dongero/dualdrum/p2/dualdrum.kicad_pcb

## KiCad design p2/dualdrum.kicad_pcb (2019-08-30)

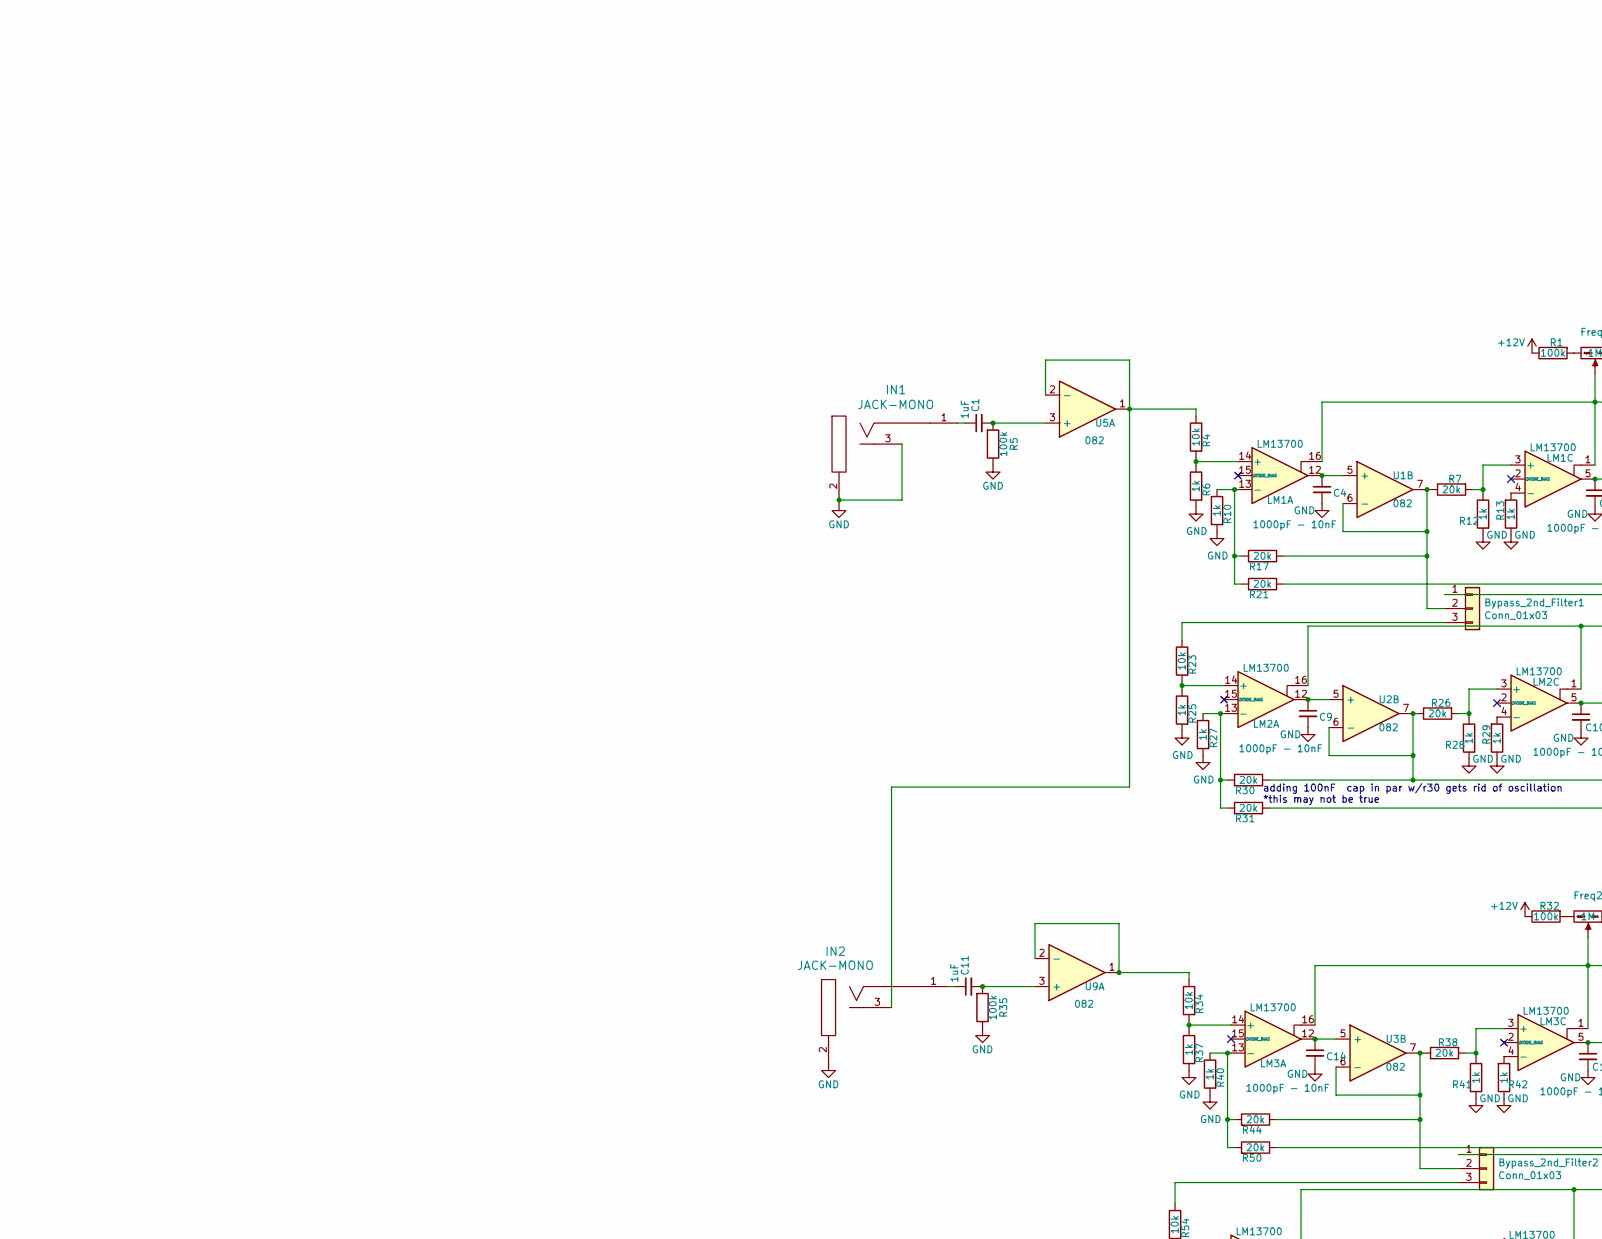
[picture p1: schematic dualdrum.sch, part in row 1, column 1]

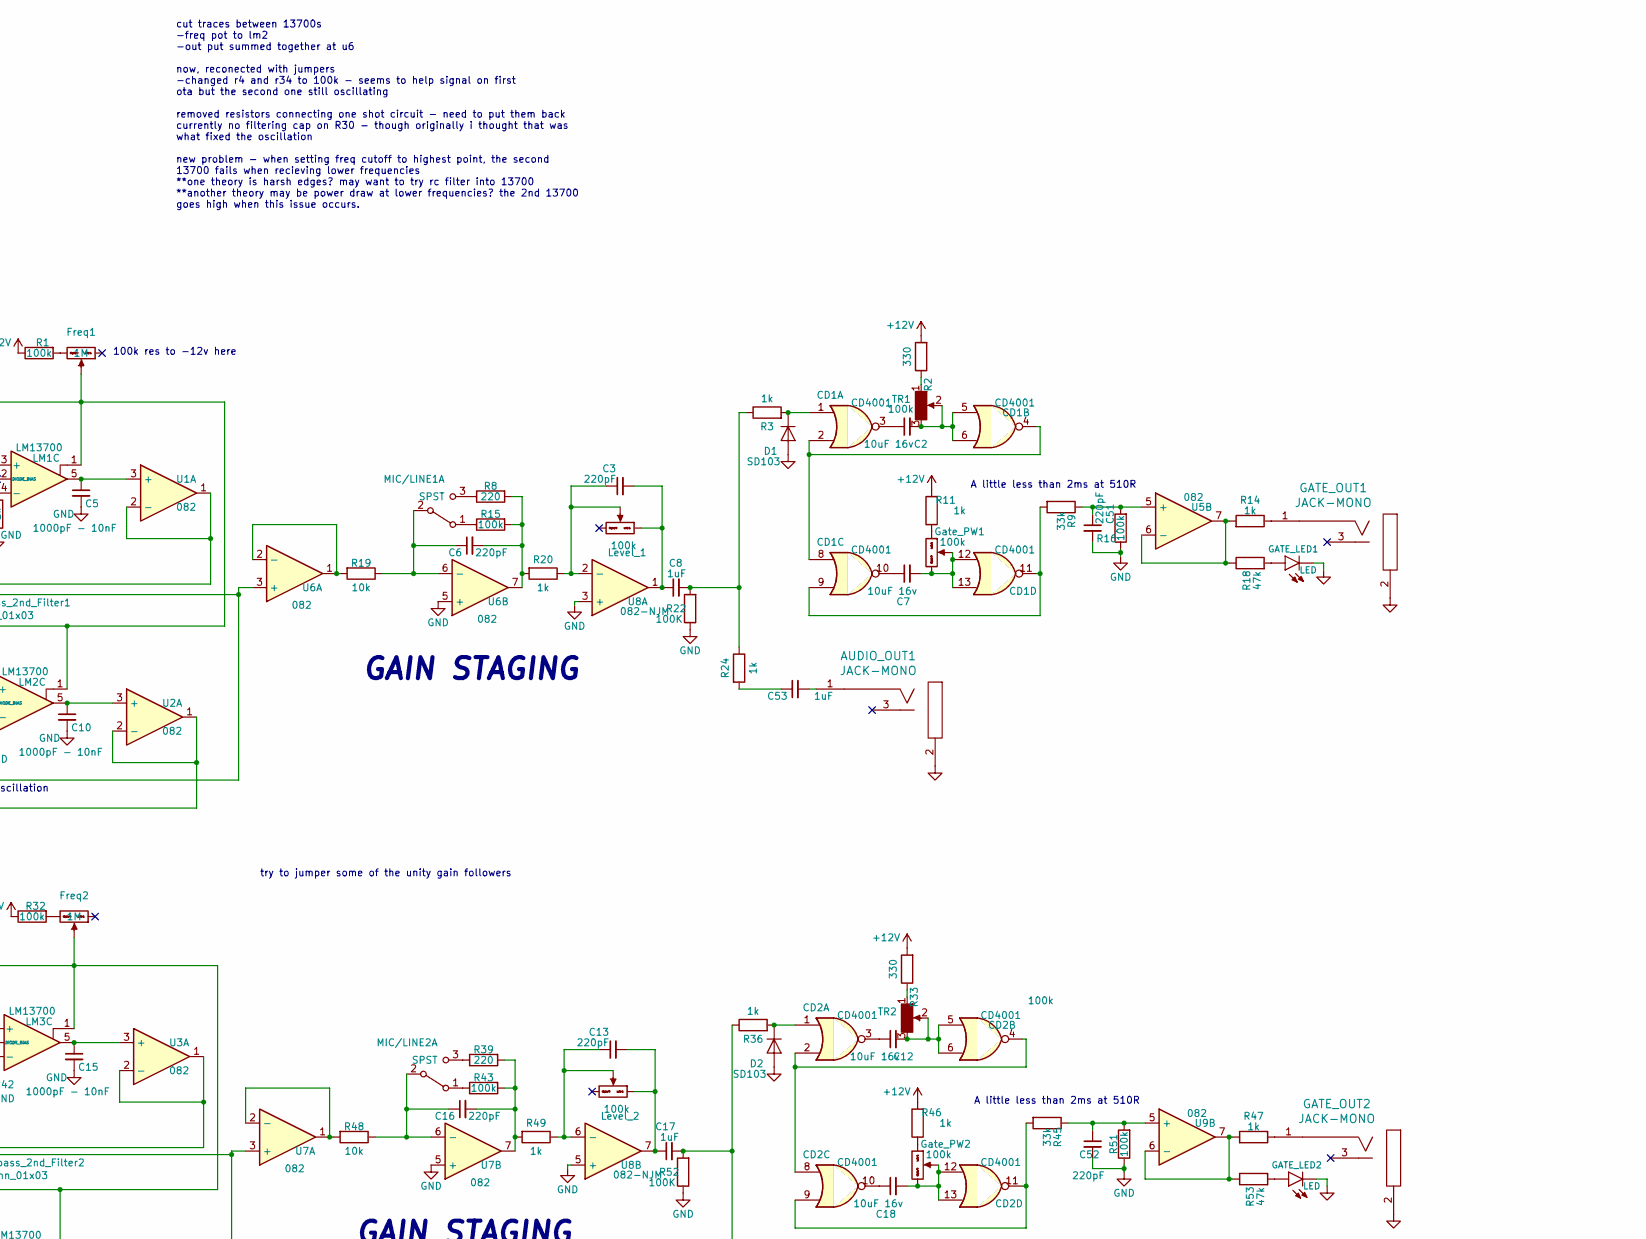
[picture p2: schematic dualdrum.sch, part in row 1, column 2]

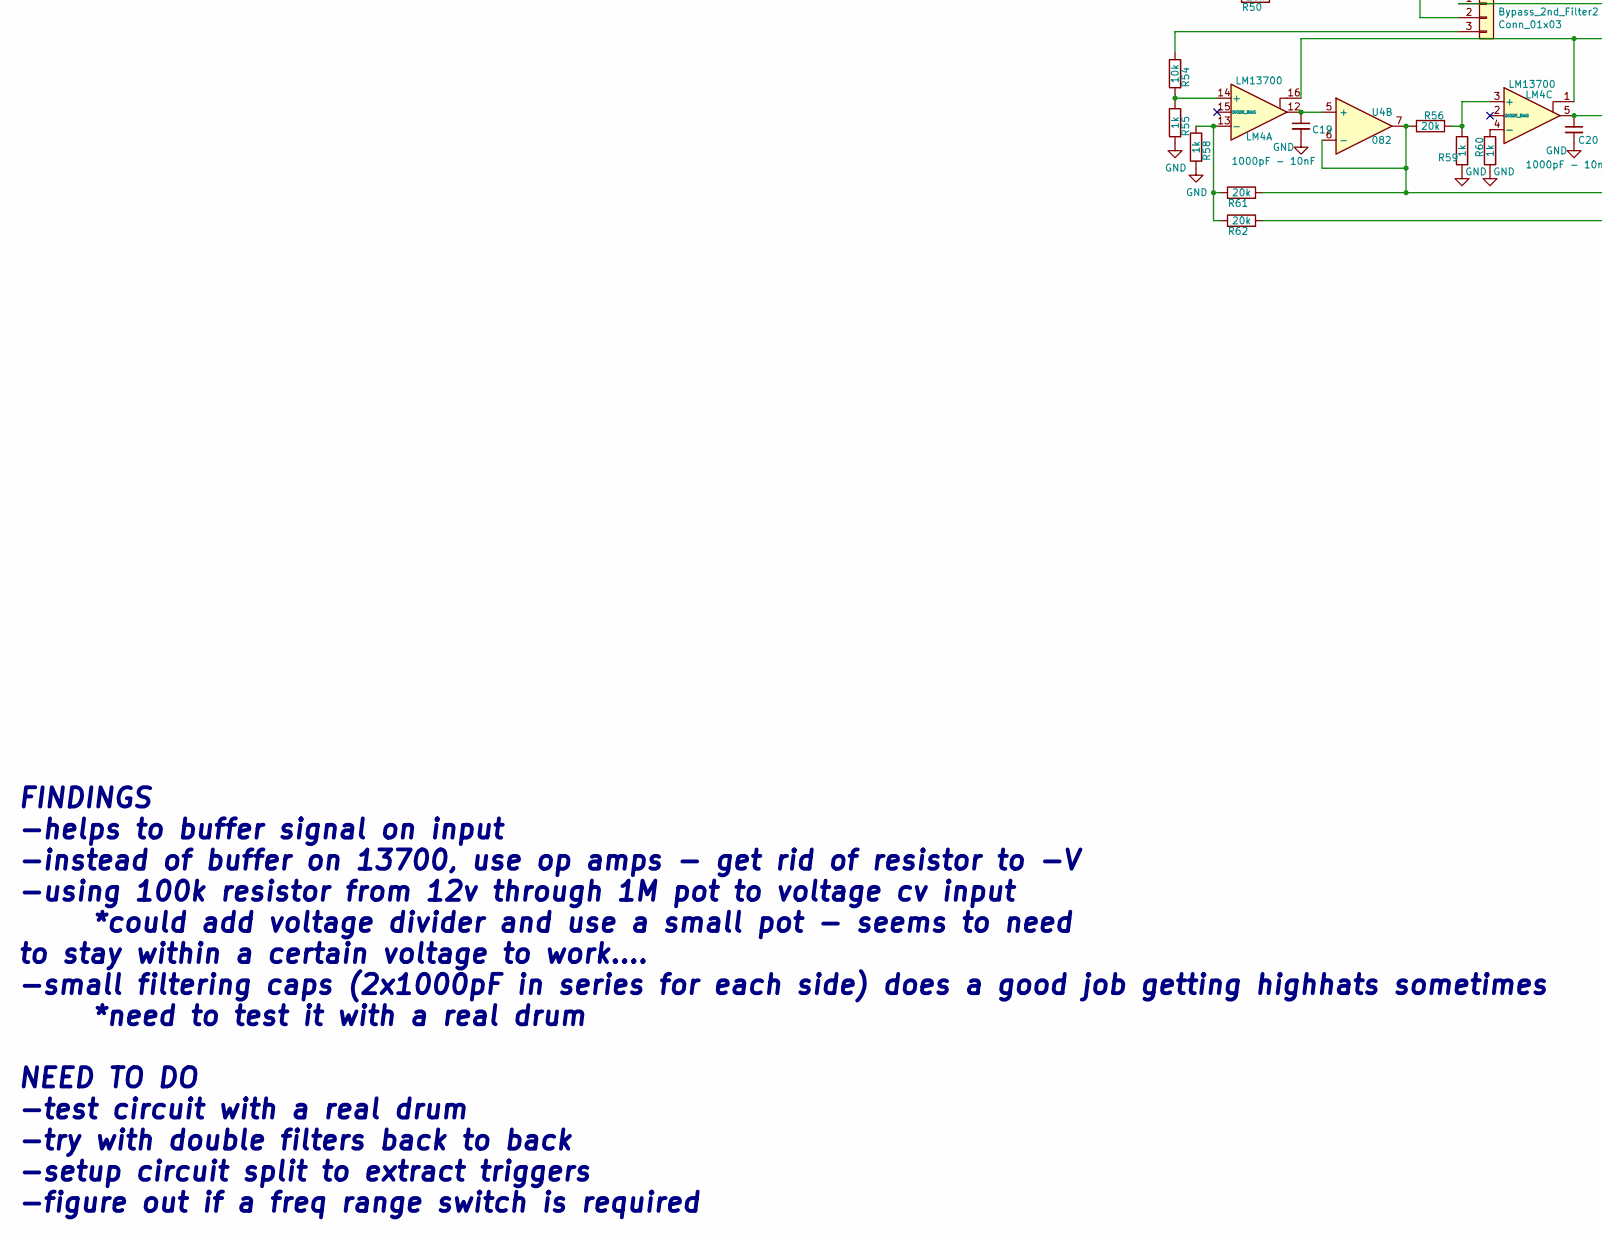
[picture p3: schematic dualdrum.sch, part in row 2, column 1]

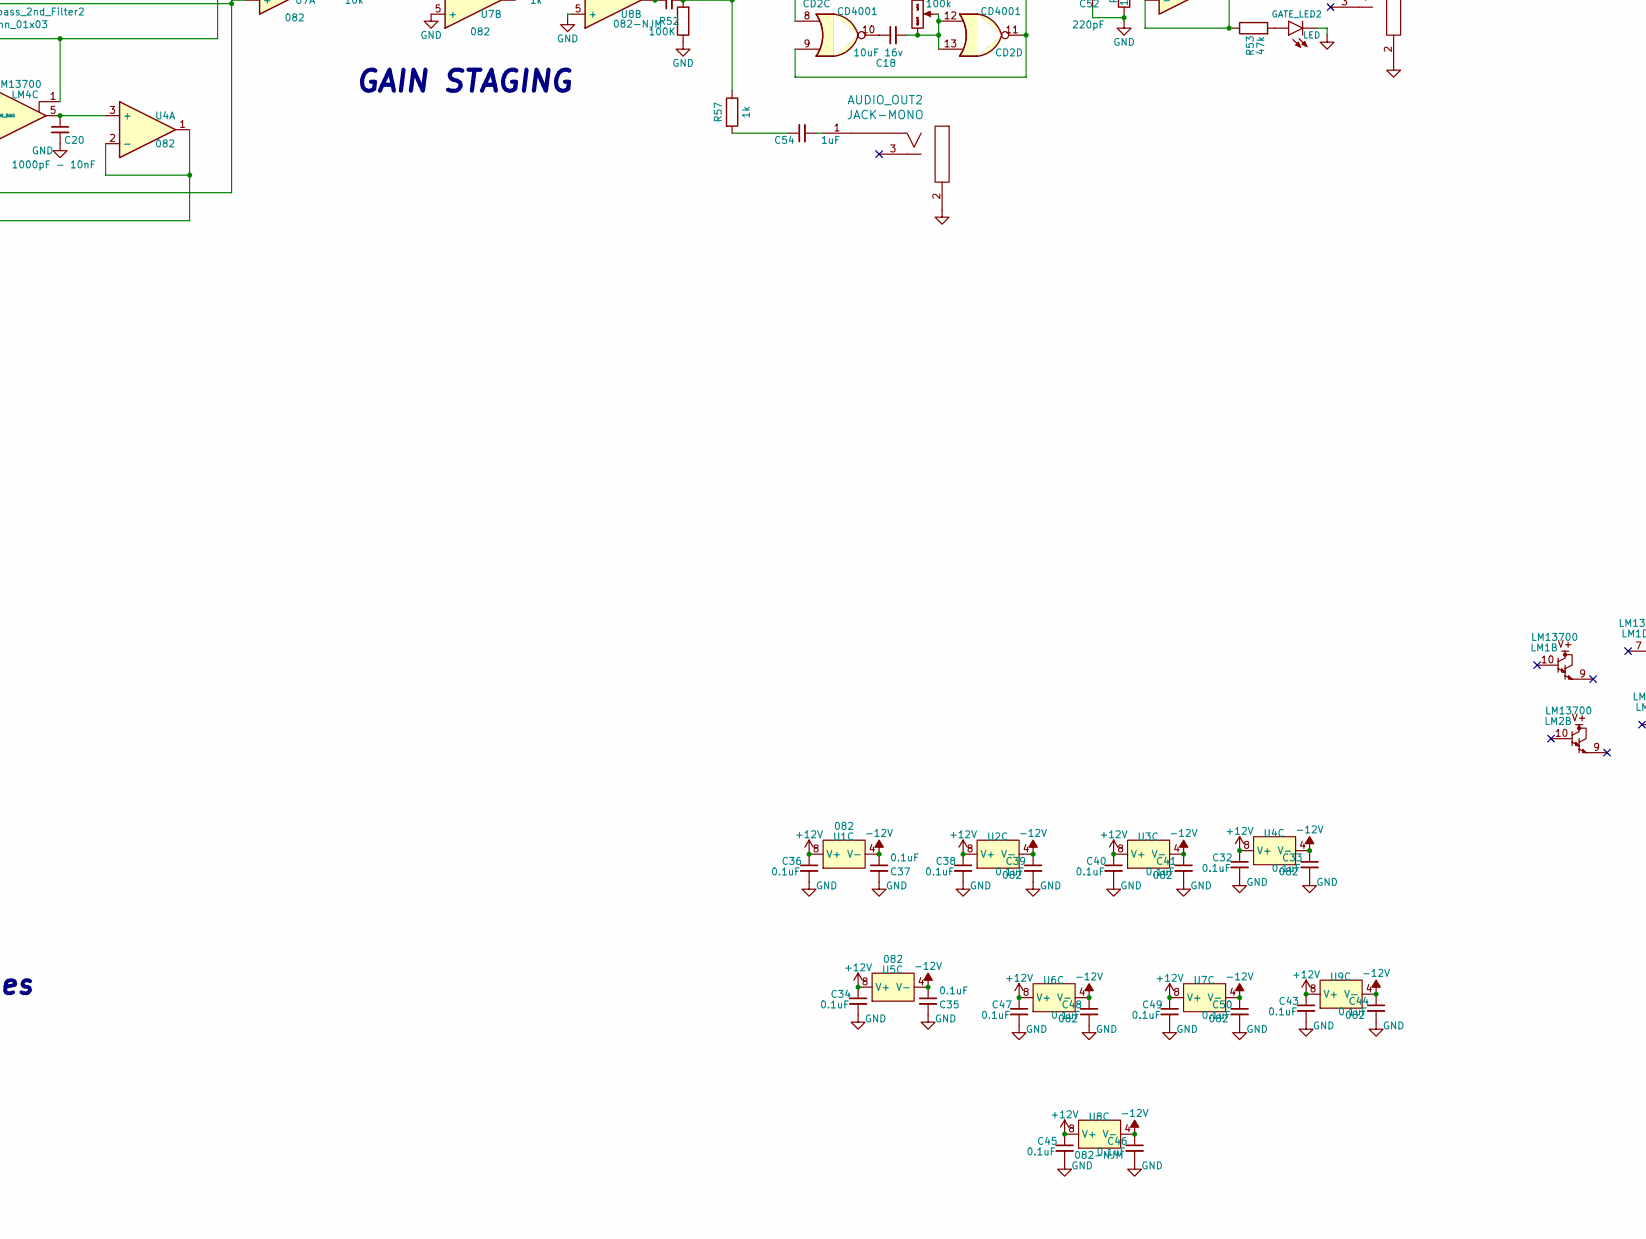
[picture p4: schematic dualdrum.sch, part in row 2, column 2]

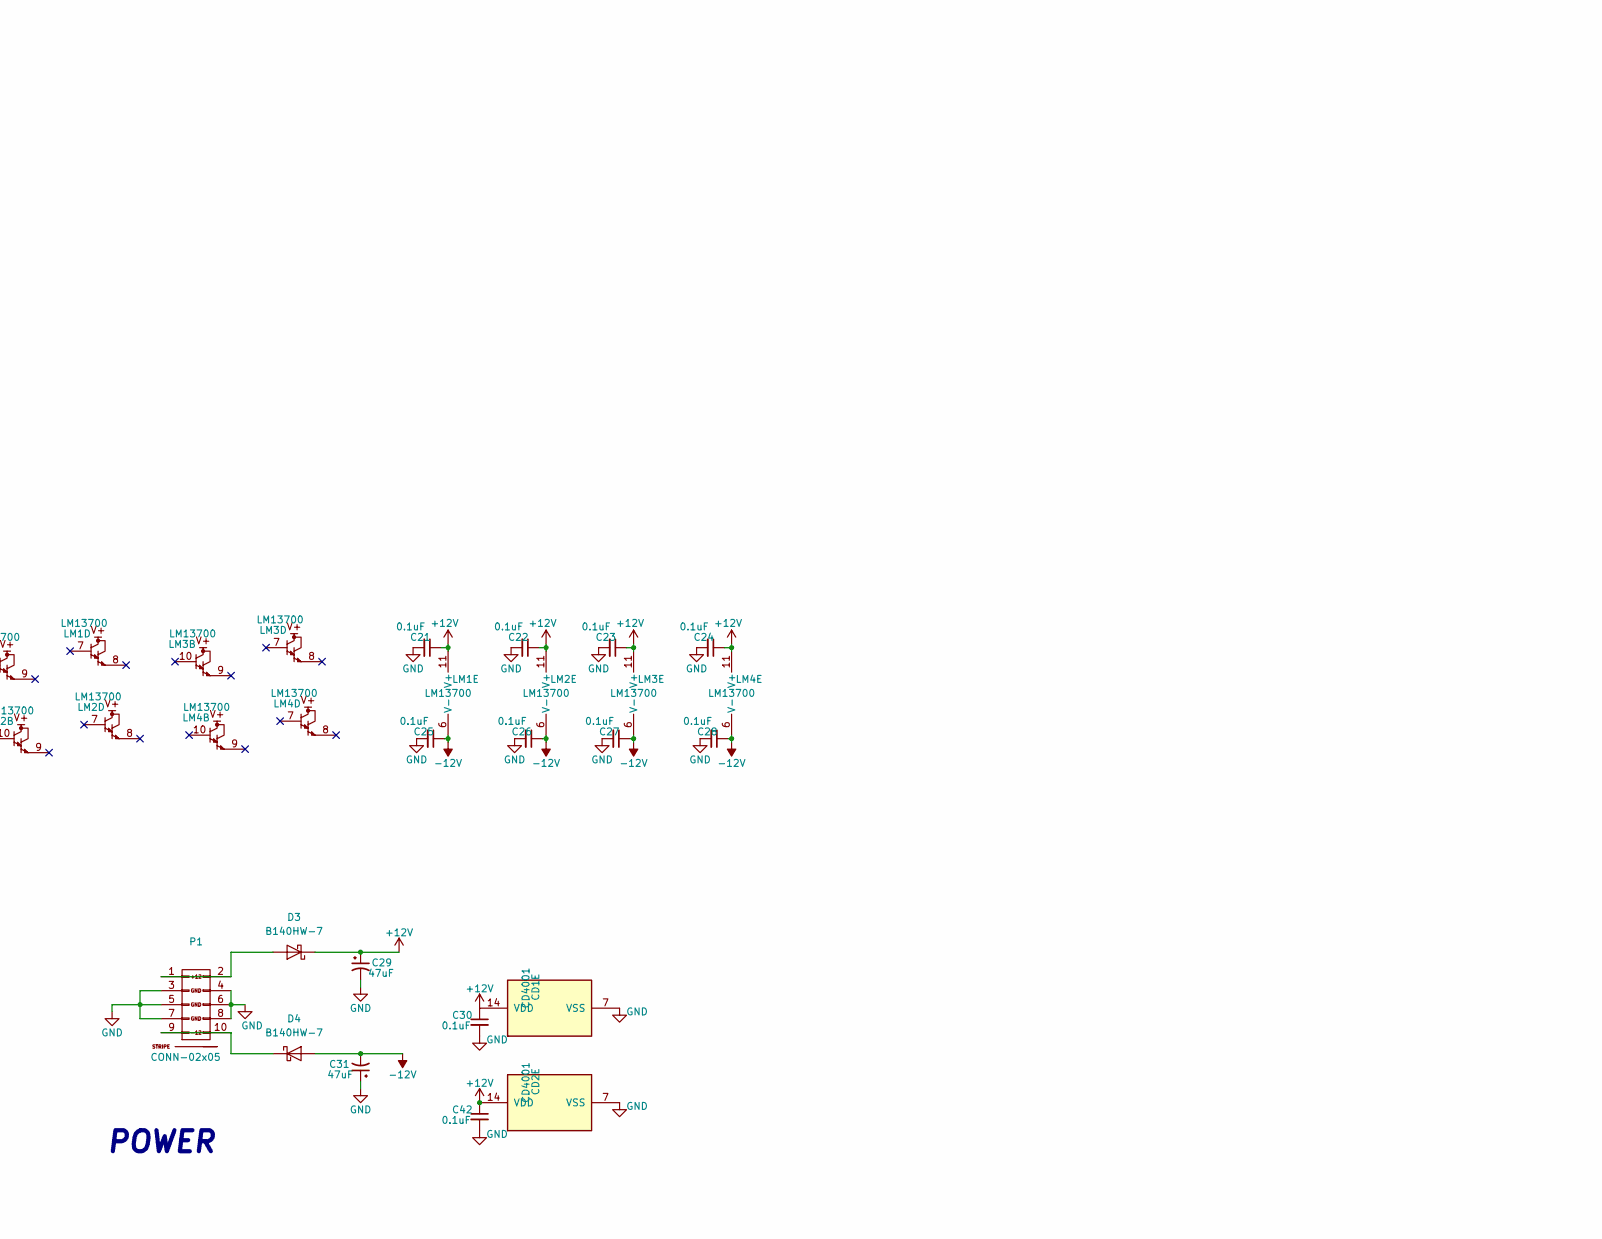
[picture p5: schematic dualdrum.sch, part in row 2, column 3]

Parts:
AUDIO_OUT1, AUDIO_OUT2: JACK-MONO; EighthInch_PJ398SM
Bypass_2nd_Filter1, Bypass_2nd_Filter2: Conn_01x03; Pins_1x03_2.54mm_TH
C1, C11: 1uF; C_0603; Part Number TES
C2, C7, C12, C18: 10uF 16v; C_0805; Part Number TEST
C3, C6, C13, C16, C51, C52: 220pF; C_0603; Part Number TEST
C4, C5, C9, C10, C14, C15, C19, C20: 1000pF - 10nF; C_0603; Part Number TEST
C8, C17, C53, C54: 1uF; C_0603; Part Number TEST
C21, C22, C23, C24, C25, C26, C27, C28, C30, C32, C33, C34, C35, C36, C37, C38, C39, C40, C41, C42, C43, C44, C45, C46, C47, C48, C49, C50: 0.1uF; C_0603; Part Number TEST
C29, C31: 47uF; CP_Elec_5x5.3; Part Number TEST
CD1, CD2: CD4001; SOIC-14_3.9x8.65mm_Pitch1.27mm
D1, D2: SD103; D_SOD-323F
D3, D4: B140HW-7; D_SOD-123
Freq1, Freq2: 1M; Pot_16mm_NoDet_RV16AF-4A
GATE_LED1, GATE_LED2: LED; LED_0603_1608Metric
GATE_OUT1, GATE_OUT2: JACK-MONO; EighthInch_PJ398SM
Gate_PW1, Gate_PW2: 100k; Pot_9mm_Knurl_NoDet
IN1, IN2: JACK-MONO; EighthInch_PJ398SM
LM1, LM2, LM3, LM4: LM13700; SOIC-16_3.9x9.9mm_Pitch1.27mm
Level_1, Level_2: 100k; Pot_16mm_NoDet_RV16AF-4A
MIC/LINE1, MIC/LINE2: SPST; Switch_Toggle_SPDT_SubMini
P1: CONN-02x05; Pins_2x05_2.54mm_TH_Europower
R1, R5, R15, R16, R32, R35, R43, R51: 100k; R_0603; Part Number RC0603FR-07XXXL
R2, R33: 330; R_0603; Part Number RC0603FR-07XXXL
R3, R6, R10, R11, R12, R13, R14, R20, R24, R25, R27, R28, R29, R36, R37, R40, R41, R42, R46, R47, R49, R55, R57, R58, R59, R60: 1k; R_0603; Part Number RC0603FR-07XXXL
R4, R19, R23, R34, R48, R54: 10k; R_0603; Part Number RC0603FR-07XXXL
R7, R17, R21, R26, R30, R31, R38, R44, R50, R56, R61, R62: 20k; R_0603; Part Number RC0603FR-07XXXL
R8, R39: 220; R_0603; Part Number RC0603FR-07XXXL
R9, R45: 33k; R_0603; Part Number RC0603FR-07XXXL
R18, R53: 47k; R_0603; Part Number RC0603FR-07XXXL
R22, R52: 100K; R_0603; Part Number RC0603FR-07XXXL
TR1, TR2: 100k; Pot_Trim_SMT_TC33X
U1, U2, U3, U4, U5, U6, U7, U9: 082; TSSOP-8_4.4x3mm_Pitch0.65mm
U8: 082-NJM; TSSOP-8_4.4x3mm_Pitch0.65mm

Connections:
+12V: C21.1, C22.1, C23.1, C24.1, C29.1, C30.1, C32.1, C34.1, C36.1, C38.1, C40.1, C42.1, C43.1, C45.1, C47.1, C49.1, CD1.14 (VDD), CD2.14 (VDD), D3.1 (K), LM1.11 (V+), LM2.11 (V+), LM3.11 (V+), LM4.11 (V+), R1.1, R2.2, R11.2, R32.1, R33.2, R46.2, U1.8 (V+), U2.8 (V+), U3.8 (V+), U4.8 (V+), U5.8 (V+), U6.8 (V+), U7.8 (V+), U8.8 (V+), U9.8 (V+)
-12VA: C25.1, C26.1, C27.1, C28.1, C31.2, C33.1, C35.1, C37.1, C39.1, C41.1, C44.1, C46.1, C48.1, C50.1, D4.2 (A), LM1.6 (V-), LM2.6 (V-), LM3.6 (V-), LM4.6 (V-), U1.4 (V-), U2.4 (V-), U3.4 (V-), U4.4 (V-), U5.4 (V-), U6.4 (V-), U7.4 (V-), U8.4 (V-), U9.4 (V-)
GND: AUDIO_OUT1.2 (SHEILD), AUDIO_OUT2.2 (SHEILD), C4.2, C5.2, C9.2, C10.2, C14.2, C15.2, C19.2, C20.2, C21.2, C22.2, C23.2, C24.2, C25.2, C26.2, C27.2, C28.2, C29.2, C30.2, C31.1, C32.2, C33.2, C34.2, C35.2, C36.2, C37.2, C38.2, C39.2, C40.2, C41.2, C42.2, C43.2, C44.2, C45.2, C46.2, C47.2, C48.2, C49.2, C50.2, C51.2, C52.2, CD1.7 (VSS), CD2.7 (VSS), D1.2 (A), D2.2 (A), GATE_LED1.2 (C), GATE_LED2.2 (C), GATE_OUT1.2 (SHEILD), GATE_OUT2.2 (SHEILD), IN1.2 (SHEILD), IN1.3 (SW), IN2.2 (SHEILD), P1.3 (GND), P1.4 (GND), P1.5 (GND), P1.6 (GND), P1.7 (GND), P1.8 (GND), R5.1, R6.2, R10.2, R12.2, R13.1, R16.1, R22.1, R25.2, R27.2, R28.2, R29.1, R35.1, R37.2, R40.2, R41.2, R42.1, R51.1, R52.1, R55.2, R58.2, R59.2, R60.1, U6.5 (+), U7.5 (+), U8.3 (+), U8.5 (+)
unnamed: AUDIO_OUT1.1 (SIG), C53.2
unnamed: AUDIO_OUT2.1 (SIG), C54.2
unnamed: Bypass_2nd_Filter1.1, R26.1, R30.1, U2.6 (-), U2.7, U6.3 (+)
unnamed: Bypass_2nd_Filter1.2, R7.1, R17.1, U1.6 (-), U1.7
unnamed: Bypass_2nd_Filter1.3, R23.1
unnamed: Bypass_2nd_Filter2.1, R56.1, R61.1, U4.6 (-), U4.7, U7.3 (+)
unnamed: Bypass_2nd_Filter2.2, R38.1, R44.1, U3.6 (-), U3.7
unnamed: Bypass_2nd_Filter2.3, R54.1
unnamed: C1.1, IN1.1 (SIG)
unnamed: C1.2, R5.2, U5.3 (+)
unnamed: C2.1, CD1.3
unnamed: C2.2, CD1.5, CD1.6, TR1.2 (Center), TR1.3 (Right)
unnamed: C3.1, Level_1.2 (Center), R20.1, U8.2 (-)
unnamed: C3.2, C8.1, Level_1.1 (Left), U8.1
unnamed: C4.1, LM1.12, U1.5 (+)
unnamed: C5.1, LM1.5, U1.3 (+)
unnamed: C6.1, MIC/LINE1.2 (B), R19.1, U6.6 (-)
unnamed: C6.2, R8.2, R15.2, R20.2, U6.7
unnamed: C7.1, CD1.10
unnamed: C7.2, CD1.12, CD1.13, Gate_PW1.2 (Center), Gate_PW1.3 (Right)
unnamed: C8.2, R3.1, R22.2, R24.1
unnamed: C9.1, LM2.12, U2.5 (+)
unnamed: C10.1, LM2.5, U2.3 (+)
unnamed: C11.1, IN2.1 (SIG)
unnamed: C11.2, R35.2, U9.3 (+)
unnamed: C12.1, CD2.3
unnamed: C12.2, CD2.5, CD2.6, TR2.2 (Center), TR2.3 (Right)
unnamed: C13.1, Level_2.2 (Center), R49.1, U8.6 (-)
unnamed: C13.2, C17.1, Level_2.1 (Left), U8.7
unnamed: C14.1, LM3.12, U3.5 (+)
unnamed: C15.1, LM3.5, U3.3 (+)
unnamed: C16.1, MIC/LINE2.2 (B), R48.1, U7.6 (-)
unnamed: C16.2, R39.2, R43.2, R49.2, U7.7
unnamed: C17.2, R36.1, R52.2, R57.1
unnamed: C18.1, CD2.10
unnamed: C18.2, CD2.12, CD2.13, Gate_PW2.2 (Center), Gate_PW2.3 (Right)
unnamed: C19.1, LM4.12, U4.5 (+)
unnamed: C20.1, LM4.5, U4.3 (+)
unnamed: C51.1, R9.1, R16.2, U5.5 (+)
unnamed: C52.1, R45.1, R51.2, U9.5 (+)
unnamed: C53.1, R24.2
unnamed: C54.1, R57.2
unnamed: CD1.1, D1.1 (K), R3.2
unnamed: CD1.2, CD1.4, CD1.8
unnamed: CD1.9, CD1.11, R9.2
unnamed: CD2.1, D2.1 (K), R36.2
unnamed: CD2.2, CD2.4, CD2.8
unnamed: CD2.9, CD2.11, R45.2
unnamed: D3.2 (A), P1.1 (+12V), P1.2 (+12V)
unnamed: D4.1 (K), P1.9 (-12V), P1.10 (-12V)
unnamed: Freq1.2 (Center), LM1.1, LM1.16, LM2.1, LM2.16
unnamed: Freq1.3 (Right), R1.2
unnamed: Freq2.2 (Center), LM3.1, LM3.16, LM4.1, LM4.16
unnamed: Freq2.3 (Right), R32.2
unnamed: GATE_LED1.1 (A), R18.2
unnamed: GATE_LED2.1 (A), R53.2
unnamed: GATE_OUT1.1 (SIG), R14.1
unnamed: GATE_OUT2.1 (SIG), R47.1
unnamed: Gate_PW1.1 (Left), R11.1
unnamed: Gate_PW2.1 (Left), R46.1
unnamed: IN2.3 (SW), R4.1, U5.1, U5.2 (-)
unnamed: LM1.3 (+), R7.2, R12.1
unnamed: LM1.4 (-), R13.2
unnamed: LM1.13 (-), R10.1, R17.2, R21.2
unnamed: LM1.14 (+), R4.2, R6.1
unnamed: LM2.3 (+), R26.2, R28.1
unnamed: LM2.4 (-), R29.2
unnamed: LM2.13 (-), R27.1, R30.2, R31.2
unnamed: LM2.14 (+), R23.2, R25.1
unnamed: LM3.3 (+), R38.2, R41.1
unnamed: LM3.4 (-), R42.2
unnamed: LM3.13 (-), R40.1, R44.2, R50.2
unnamed: LM3.14 (+), R34.2, R37.1
unnamed: LM4.3 (+), R56.2, R59.1
unnamed: LM4.4 (-), R60.2
unnamed: LM4.13 (-), R58.1, R61.2, R62.2
unnamed: LM4.14 (+), R54.2, R55.1
unnamed: MIC/LINE1.1 (A), R15.1
unnamed: MIC/LINE1.3 (C), R8.1
unnamed: MIC/LINE2.1 (A), R43.1
unnamed: MIC/LINE2.3 (C), R39.1
unnamed: R2.1, TR1.1 (Left)
unnamed: R14.2, R18.1, U5.6 (-), U5.7
unnamed: R19.2, U6.1, U6.2 (-)
unnamed: R21.1, U1.1, U1.2 (-)
unnamed: R31.1, U2.1, U2.2 (-)
unnamed: R33.1, TR2.1 (Left)
unnamed: R34.1, U9.1, U9.2 (-)
unnamed: R47.2, R53.1, U9.6 (-), U9.7
unnamed: R48.2, U7.1, U7.2 (-)
unnamed: R50.1, U3.1, U3.2 (-)
unnamed: R62.1, U4.1, U4.2 (-)

Notes on the sheet:
A little less than 2ms at 510R
GAIN STAGING
FINDINGS -helps to buffer signal on input -instead of buffer on 13700, use op amps - get rid of resistor to -V -using 100k resistor from 12v through 1M pot to voltage cv input *could add voltage divider and use a small pot - seems to need to stay within a certain voltage to work…. -small filtering 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
POWER
try to jumper some of the unity gain followers
100k res to -12v here
cut traces between 13700s -freq pot to lm2 -out put summed together at u6 now, reconected with jumpers -changed r4 and r34 to 100k - seems to help signal on first ota but the second one still oscillating removed resistors connecting one shot circuit - need to put them back currently no filtering ca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
adding 100nF cap in par w/r30 gets rid of oscillation *this may not be true

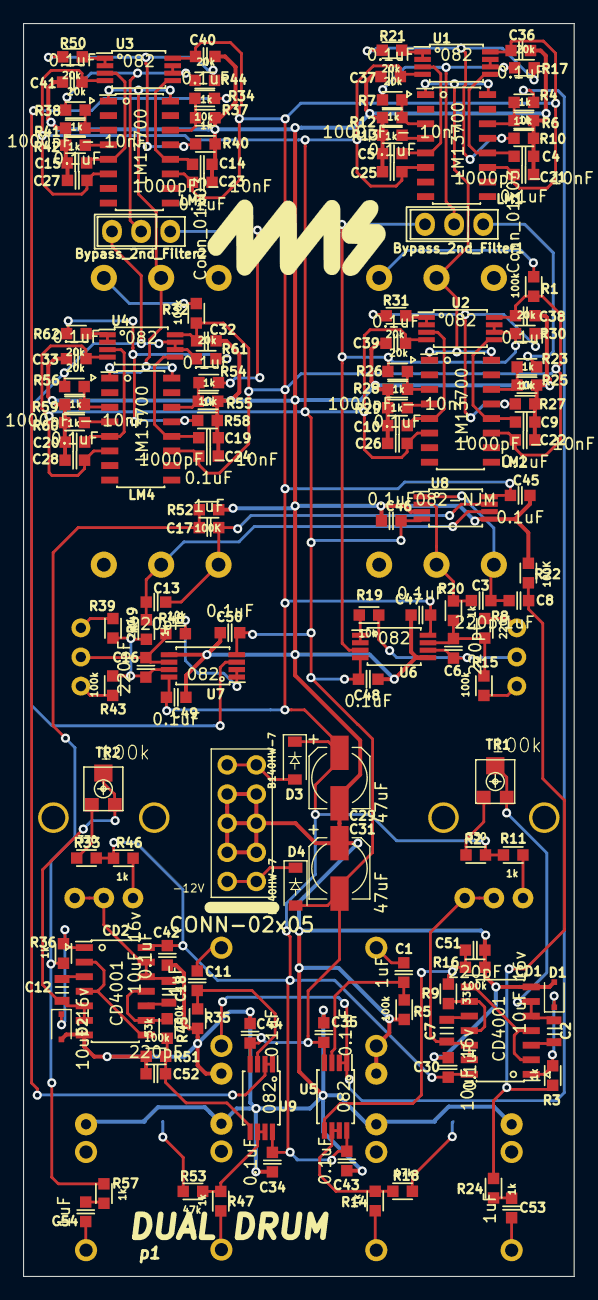
[picture p6: board dualdrum.kicad_pcb from above]

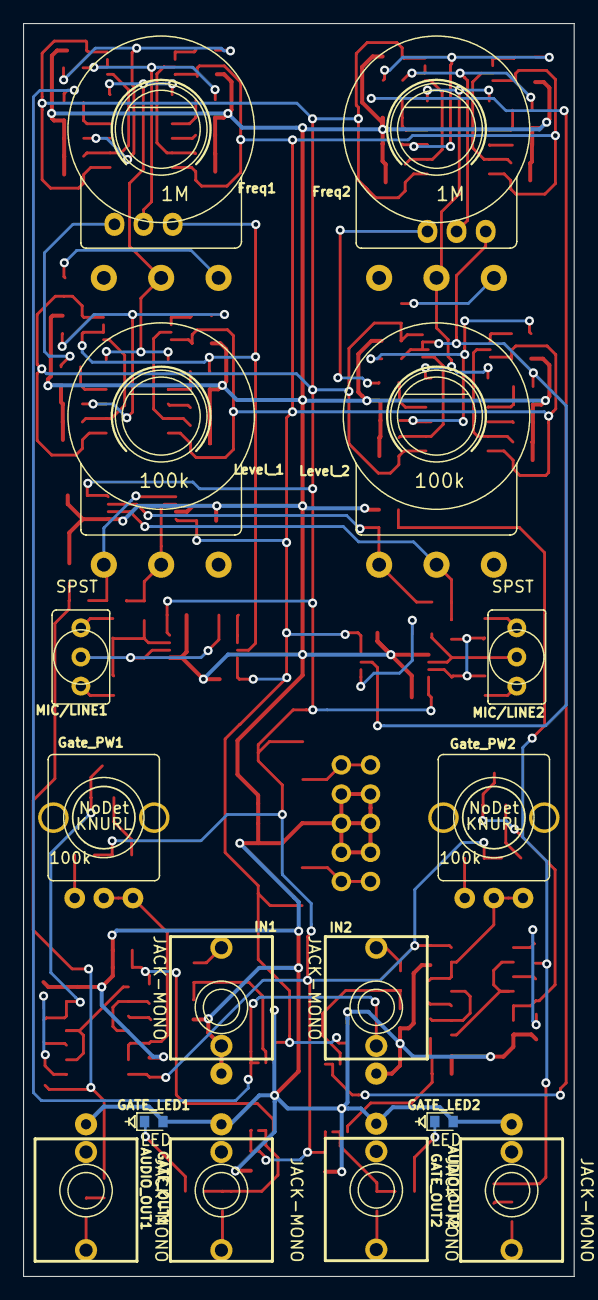
[picture p7: board dualdrum.kicad_pcb from below]

Board: 2 copper layers, 48.0 x 109.2 mm, 156 parts (16 on the bottom side), 95 nets.
