dongero/dualdrum/(commit log)

2019-08-07 created project
    [pcb-dualdrum.kicad_pcb, pcb-dualdrum.sch]
2019-08-07 found 13700
    [Drum-interface_p7.sch, pcb-dualdrum.sch]
2019-08-11 added notes
    [seg.sch]
2019-08-14 laid 7660 circuit
2019-08-14 wip on lm13700 circuits
    [pcb-dualdrum.sch, seg.sch]
2019-08-14 wip incorperated PI circuit
    [pcb-dualdrum.sch]
2019-08-14 ok time to take a break
    [pcb-dualdrum.sch]
2019-08-21 added new schem + notes
    [pcb-dualdrum.sch]
2019-08-25 created dualdrumdev
    [Drum-interface_p8.sch, pcb-dualdrum-dev1.sch, seg.sch]
2019-08-25 setup power
    [Drum-interface_p8.sch, pcb-dualdrum-dev1.sch]
2019-08-26 about to annotate parts
    [pcb-dualdrum-dev1.sch]
2019-08-26 layed pots and jacks
    [pcb-dualdrum-dev1.kicad_pcb]
2019-08-26 grouped components
    [pcb-dualdrum-dev1.kicad_pcb, pcb-dualdrum-dev1.sch]
2019-08-26 good stopping point
    [pcb-dualdrum-dev1.kicad_pcb]
2019-08-27 placed all components
    [pcb-dualdrum-dev1.kicad_pcb]
2019-08-27 created fp file - ready to layout dev board
    [fp-dd-dev1.kicad_pcb, pcb-dualdrum-dev1.kicad_pcb]
2019-08-27 beginning to lay tracks
    [pcb-dualdrum-dev1.kicad_pcb, pcb-dualdrum-dev1.sch]
2019-08-28 finished pwr and gnd tracks
    [pcb-dualdrum-dev1.kicad_pcb]
2019-08-28 about to run drc
    [pcb-dualdrum-dev1.kicad_pcb]
2019-08-28 drc cleared - checking for more mistakes
    [pcb-dualdrum-dev1.kicad_pcb]
2019-08-28 organized front refs
    [pcb-dualdrum-dev1.kicad_pcb, pcb-dualdrum-dev1.sch]
2019-08-28 organized refs - review with fresh eyes
    [pcb-dualdrum-dev1.kicad_pcb]
2019-08-29 made font bigger
    [pcb-dualdrum-dev1.kicad_pcb]
2019-08-29 looks good - ready to plot
    [pcb-dualdrum-dev1.kicad_pcb, pcb-dualdrum-dev1.sch]
2019-08-29 plotted fp gerbers
    [fp-dd-dev1-B_Cu.gbr, fp-dd-dev1-B_Mask.gbr, fp-dd-dev1-Edge_Cuts.gbr, fp-dd-dev1-F_Cu.gbr, fp-dd-dev1-F_Mask.gbr, fp-dd-dev1-F_SilkS.gbr, fp-dd-dev1-drl_map.gbr, fp-dd-dev1.drl]
2019-08-29 generated grbs - submitted to pcbcart
    [pcb-dualdrum-dev1-B_Cu.gbr, pcb-dualdrum-dev1-B_Mask.gbr, pcb-dualdrum-dev1-B_Paste.gbr, pcb-dualdrum-dev1-B_SilkS.gbr, pcb-dualdrum-dev1-Edge_Cuts.gbr, pcb-dualdrum-dev1-F_Cu.gbr, pcb-dualdrum-dev1-F_Mask.gbr, pcb-dualdrum-dev1-F_Paste.gbr]
2019-08-30 created pi - ready to import to 4ms git
    [Drum-interface_p8.sch, dualdrum.kicad_pcb, dualdrum.sch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]
2019-08-30 started new vco-vca-env project
    [Drum-interface.sch, pcb-dualdrum.kicad_pcb, pcb-dualdrum.sch]
2019-08-30 generated gerbers and ordered p1
    [dualdrum-B_Cu.gbr, dualdrum-B_Mask.gbr, dualdrum-B_Paste.gbr, dualdrum-B_SilkS.gbr, dualdrum-Edge_Cuts.gbr, dualdrum-F_Cu.gbr, dualdrum-F_Mask.gbr, dualdrum-F_Paste.gbr]
2019-09-25 created p2 - made notes on schematic - getting p1 to function
    [dualdrum.kicad_pcb, dualdrum.sch]
2019-09-26 added notes - made more tests
    [dualdrum.sch]
